hattabith/OrbitRotationImitation/Schematic_OrbitImitatorRotation.pdf

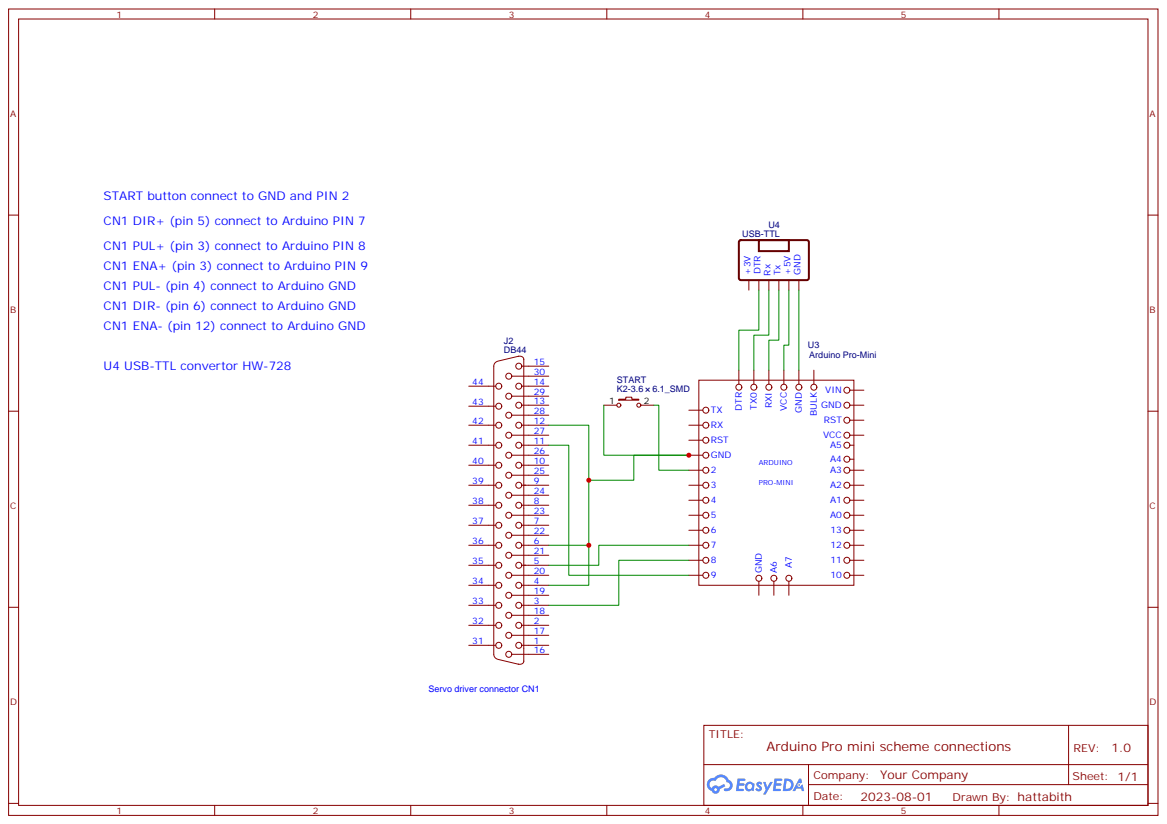
[picture p2: page 1]

START button connect to GND and PIN 2
CN1 DIR+ (pin 5) connect to Arduino PIN 7
CN1 PUL+ (pin 3) connect to Arduino PIN 8
CN1 ENA+ (pin 3) connect to Arduino PIN 9
CN1 PUL- (pin 4) connect to Arduino GND
CN1 DIR- (pin 6) connect to Arduino GND
CN1 ENA- (pin 12) connect to Arduino GND

U4 USB-TTL convertor HW-728
