hattabith/OrbitRotationImitation/OrbitImitationRotatorProMini/src/main.cpp

/*
*
*OrientationRotationProMini
*
*MIT License
*Copyright (c) 2023 Dmytro Myronov <hattabith@gmail.com>
*
*
*Program for controlling a stepper motor for satellite rotation in a vacuum chamber.
*It simulates the passage of a satellite under the sunlit conditions on orbit. When the sun hides behind the Earth - it returns to the previous state.
*The start is when the sun rises, the end is when the sun sets.
*
*Initial data:
*
*Total rotation time 97.5 minutes
*Time while sunlit 54.5 minutes
*Time in shadow 43 minutes
*number of test cycles 5-7
*
*
*Calculations:
*
*Rotation angle 201.23 (fact 201.6)
*Motor step 1.8 degrees
*Motor step reduction 0.3 degrees
*Motor step reduction and step resolution 4000 is 0.015
*Stepper motor should make 112 steps
*Stepper motor should make 13440 steps if use reduction and step resolution 4000 (default value)

*The sunlit side lasts 3270 seconds
*In the Earth shadow lasts 2580 seconds
*Total time of orbit 5850
*
*If we need to use reduction and step resolution we have:
*One step in 243304 microseconds
*Stepper motor should make 13440 steps
*
*When satellite in shadow we slowly return in start position and wait end of cycle 2580 seconds
*Return speed is not defined, I use about 4:30 minutes return
*
*/

#include <Arduino.h>
#include <Wire.h>
#include <BasicStepperDriver.h>

#define ORBIT_TIME 5850L      // Orbit cycle
#define ORBIT_SUN_LIGHT 3270L // The Sun light
#define ORBIT_SHADOW 2580L    // Shadow

#define STEPPER_MOTOR_STEP_ANGLE 1.8                  // If motor steps is 200
#define STEPPER_MOTOR_STEP_ANGLE_REDUCTION 0.3        // If use reduction
#define STEPPER_MOTOR_STEP_ANGLE_REDUCTION_4000 0.015 // If motor steps is 4000 (current value, default for driver)
#define REDUCTION_COEFFICIENT 0.166667                // Reduction is 1:6
#define ANGLE_SUN_LIGHT_ROTATION 201.6                // The Sun is shining on satellite
#define STEP_PERIOD_MILLIS 243L                       // If motor steps is 200
#define STEP_PERIOD_REDUCTION_MICROS_4000 243304L     // If motor steps is 4000 (current value, default for driver)
#define NUMBER_OF_STEPS 112                           // If motor steps is 200
#define NUMBER_OF_STEPS_REDUCTION_4000 13440          // If use reduction and motor speed is 4000
#define RETURN_PERIOD_MILLIS 10L                      // Return period steps

#define MOTOR_STEPS 4000 // Current value, default for stepper driver
#define DIR 8            // Direction pin
#define STEP 7           // Pulse pin
#define ENABLE 9         // Enable pin
#define RPM 120          // Rotate per minutes
#define MICROSTEPS 1     // Micro steps (1=full step, 2=half step etc.)

#define MESSAGE_PERIOD 10000 // message period

#define ISR_PIN_START 2 // pin number for button

/*-----------------------------------------------------------------*/

unsigned long timerStep = 0;         // timer for micros function. Period for steps
unsigned long timerMessage = 0;      // timer for serial port message
unsigned long timerReturn = 0;       // timer for return to start position
unsigned long timerShadow = 0;       // timer for Shadow
boolean startCycle = false;          // state stepper motor
byte cyclesNumber = 0;               // test cycles number
int i = 0;                           // index for step number
volatile uint32_t debounce = 0;      // debounce for button
volatile boolean IsCycle = false;    // cycle flag
volatile boolean IsSunLight = false; // the Sun light flag
volatile boolean IsShadow = false;   // shadow flag

/*-----------------------------------------------------------------*/

BasicStepperDriver stepper(MOTOR_STEPS, DIR, STEP);

// function declarations:

void StartButtonISR();

void setup()
{

  // serial port configuration
  Serial.begin(9600);

  // stepper driver configuration
  stepper.begin(RPM, MICROSTEPS);

  // ISR port configuration
  pinMode(ISR_PIN_START, INPUT_PULLUP);
  attachInterrupt(digitalPinToInterrupt(ISR_PIN_START), StartButtonISR, FALLING);

  // set up start parameters
  IsCycle = false;
  IsSunLight = false;
  IsShadow = false;
  i = 0;

  delay(10000); // init delay

  // start message
  Serial.println("");
  Serial.println("Stepper motor with reduction!!! (1/6)");
  Serial.println("");
  Serial.println("Total rotation time 97.5 minutes");
  Serial.println("Time while sunlit 54.5 minutes");
  Serial.println("Time in shadow 43 minutes");
  Serial.println("");
  Serial.println("Rotation angle 201");
  Serial.println("Motor step 0.015 degrees");
  Serial.println("Stepper motor should make 13440 steps");
  Serial.println("The sunlit side lasts 3270 seconds");
  Serial.println("One step in 243304 microseconds");
  Serial.println("Total time of orbit 5850");
  Serial.println("");
  Serial.println("**********************************");
  Serial.println();

  delay(5000); // init delay
}

void loop()
{
  // add cycle number
  if (IsCycle == true && IsShadow == false && i == 0)
  {
    cyclesNumber++;
    IsSunLight = true;
  }
  // send message to terminal every MESSAGE_PERIOD
  if (millis() - timerMessage >= MESSAGE_PERIOD && IsCycle == true)
  {
    timerMessage = millis();
    Serial.print("The current angle is:");
    Serial.print(";  ");
    Serial.print((i + 1) * STEPPER_MOTOR_STEP_ANGLE_REDUCTION_4000);
    Serial.print(";  ");
    Serial.print("Step number is:");
    Serial.print(";  ");
    Serial.print(i);
    Serial.print(";  ");
    Serial.print("The Sun light:");
    Serial.print(";  ");
    Serial.print(IsSunLight);
    Serial.print(";  ");
    Serial.print("The shadow:");
    Serial.print(";  ");
    Serial.print(IsShadow);
    Serial.print(";  ");
    Serial.print("Cycle number:");
    Serial.print(";  ");
    Serial.print(cyclesNumber);
    Serial.println(";  ");
  }

  // do step when The Sun is lighting
  if (IsCycle == true && IsSunLight == true && i < NUMBER_OF_STEPS_REDUCTION_4000 && micros() - timerStep >= STEP_PERIOD_REDUCTION_MICROS_4000)
  {
    timerStep = micros();
    stepper.move(-1);
    i++;
  }
  // when NUMBER_OF_STEPS_REDUCTION_4000, change flags
  if (i == NUMBER_OF_STEPS_REDUCTION_4000)
  {
    IsSunLight = false;
    IsShadow = true;
  }
  // set timer for shadow
  if (IsShadow == true && i == NUMBER_OF_STEPS_REDUCTION_4000)
  {
    timerShadow = millis();
  }
  // return stepper to start position
  if (IsShadow == true && IsCycle == true && millis() - timerReturn >= RETURN_PERIOD_MILLIS && i > 0)
  {
    timerReturn = millis();
    stepper.move(1);
    i--;
  }
  // when shadow cycle finish, set flags
  if (millis() - timerShadow >= ORBIT_SHADOW * 1000L && IsShadow == true)
  {
    IsCycle = false;
    IsSunLight = false;
    IsShadow = false;
    i = 0;
    Serial.println("Cycle finish ***************************");
  }
}

// function definitions:
void StartButtonISR() // ISR handler, debounce button
{
  if ((millis() - debounce >= 200) && digitalRead(ISR_PIN_START))
  {
    debounce = millis();
    IsCycle = true;
  }
}
