hattabith/OrbitRotationImitation/(commit log)

2023-07-08 Add setup and include stepper driver
2023-07-26 Rewrite code on millis/micros. First generation, without testing
2023-08-01 Add readme.md electricity schematic
2023-08-01 Add readme.md PDF Schematic
